hunterchev/baffle-muffler/out/handoff/MUF-000_assembly.dxf

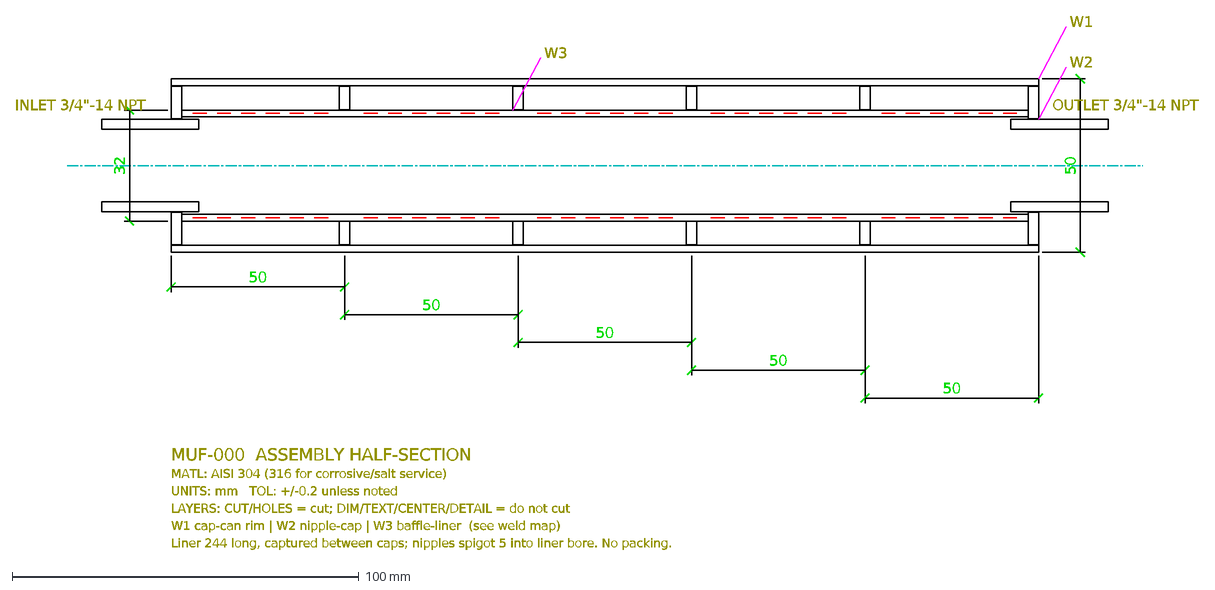
[picture p1: CAD file, 2026-10-25]
out/handoff/MUF-000_assembly.dxf
50
32
W1
W2
W3
INLET 3/4"-14 NPT
OUTLET 3/4"-14 NPT
MUF-000 ASSEMBLY HALF-SECTION
MATL: AISI 304 (316 for corrosive/salt service)
UNITS: mm TOL: +/-0.2 unless noted
LAYERS: CUT/HOLES = cut; DIM/TEXT/CENTER/DETAIL = do not cut
W1 cap-can rim | W2 nipple-cap | W3 baffle-liner (see weld map)
Liner 244 long, captured between caps; nipples spigot 5 into liner bore. No packing.
