hunterchev/baffle-muffler/out/handoff/MUF-001_outer_can.dxf

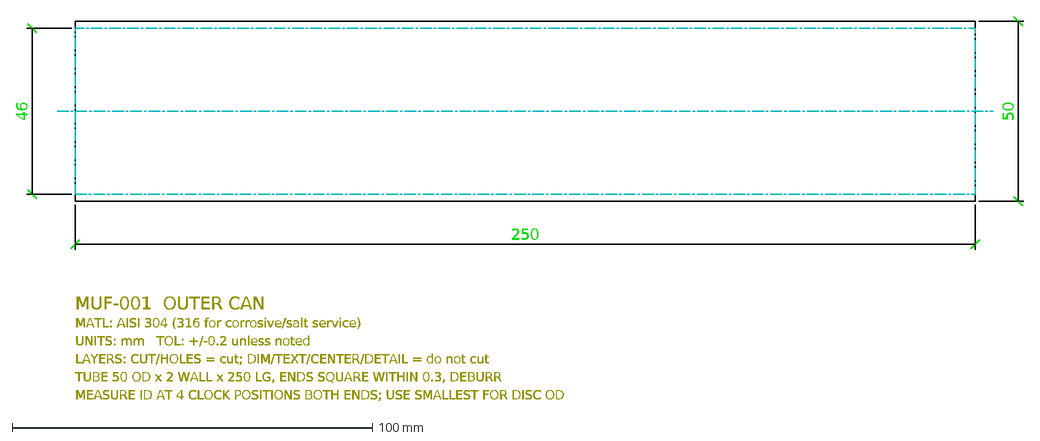
[picture p2: CAD file, 2026-10-25]
out/handoff/MUF-001_outer_can.dxf
250
50
46
MUF-001 OUTER CAN
MATL: AISI 304 (316 for corrosive/salt service)
UNITS: mm TOL: +/-0.2 unless noted
LAYERS: CUT/HOLES = cut; DIM/TEXT/CENTER/DETAIL = do not cut
TUBE 50 OD x 2 WALL x 250 LG, ENDS SQUARE WITHIN 0.3, DEBURR
MEASURE ID AT 4 CLOCK POSITIONS BOTH ENDS; USE SMALLEST FOR DISC OD
