hunterchev/baffle-muffler/out/handoff/drill_jig.dxf

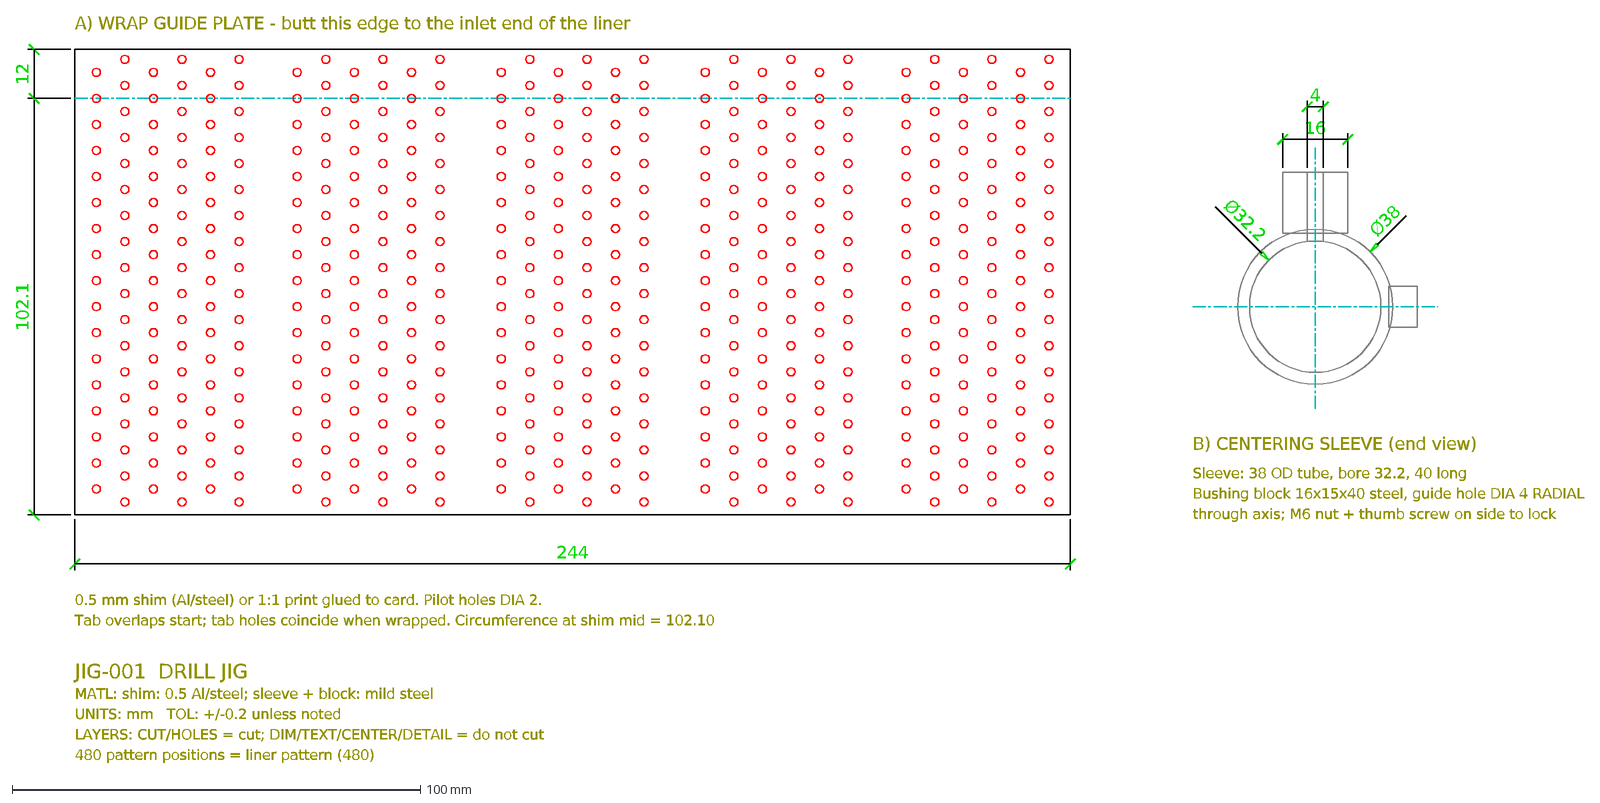
[picture p3: CAD file, 2026-10-25]
out/handoff/drill_jig.dxf
244
102.1
12
A) WRAP GUIDE PLATE - butt this edge to the inlet end of the liner
0.5 mm shim (Al/steel) or 1:1 print glued to card. Pilot holes DIA 2.
Tab overlaps start; tab holes coincide when wrapped. Circumference at shim mid = 102.10
Ø38
Ø32.2
16
4
B) CENTERING SLEEVE (end view)
Sleeve: 38 OD tube, bore 32.2, 40 long
Bushing block 16x15x40 steel, guide hole DIA 4 RADIAL
through axis; M6 nut + thumb screw on side to lock
JIG-001 DRILL JIG
MATL: shim: 0.5 Al/steel; sleeve + block: mild steel
UNITS: mm TOL: +/-0.2 unless noted
LAYERS: CUT/HOLES = cut; DIM/TEXT/CENTER/DETAIL = do not cut
480 pattern positions = liner pattern (480)
