hunterchev/baffle-muffler/out/handoff/MUF-004_baffle.dxf

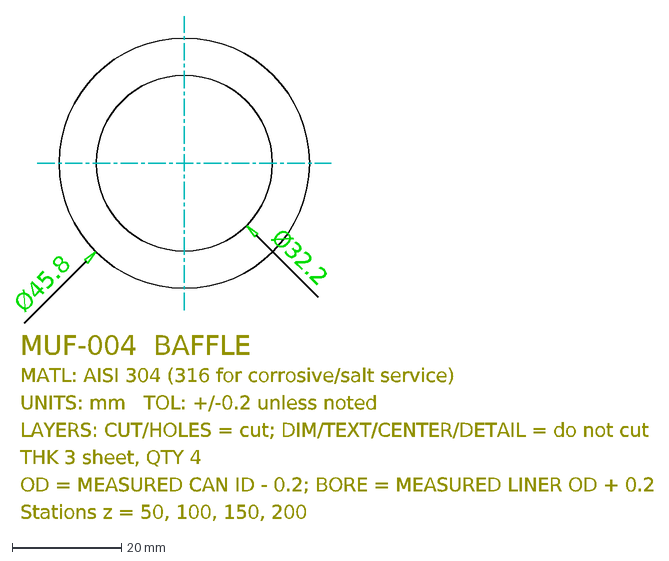
[picture p4: CAD file, 2026-10-25]
out/handoff/MUF-004_baffle.dxf
Ø45.8
Ø32.2
MUF-004 BAFFLE
MATL: AISI 304 (316 for corrosive/salt service)
UNITS: mm TOL: +/-0.2 unless noted
LAYERS: CUT/HOLES = cut; DIM/TEXT/CENTER/DETAIL = do not cut
THK 3 sheet, QTY 4
OD = MEASURED CAN ID - 0.2; BORE = MEASURED LINER OD + 0.2
Stations z = 50, 100, 150, 200
