hunterchev/baffle-muffler/out/handoff/MUF-003_end_cap.dxf

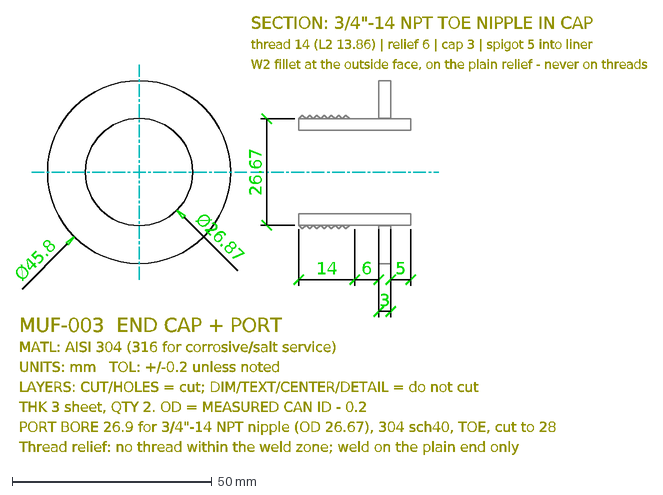
[picture p5: CAD file, 2026-10-25]
out/handoff/MUF-003_end_cap.dxf
Ø45.8
Ø26.87
14
6
3
5
26.67
SECTION: 3/4"-14 NPT TOE NIPPLE IN CAP
thread 14 (L2 13.86) | relief 6 | cap 3 | spigot 5 into liner
W2 fillet at the outside face, on the plain relief - never on threads
MUF-003 END CAP + PORT
MATL: AISI 304 (316 for corrosive/salt service)
UNITS: mm TOL: +/-0.2 unless noted
LAYERS: CUT/HOLES = cut; DIM/TEXT/CENTER/DETAIL = do not cut
THK 3 sheet, QTY 2. OD = MEASURED CAN ID - 0.2
PORT BORE 26.9 for 3/4"-14 NPT nipple (OD 26.67), 304 sch40, TOE, cut to 28
Thread relief: no thread within the weld zone; weld on the plain end only
