hunterchev/baffle-muffler/out/handoff/MUF-002_liner_wrap_layout.dxf

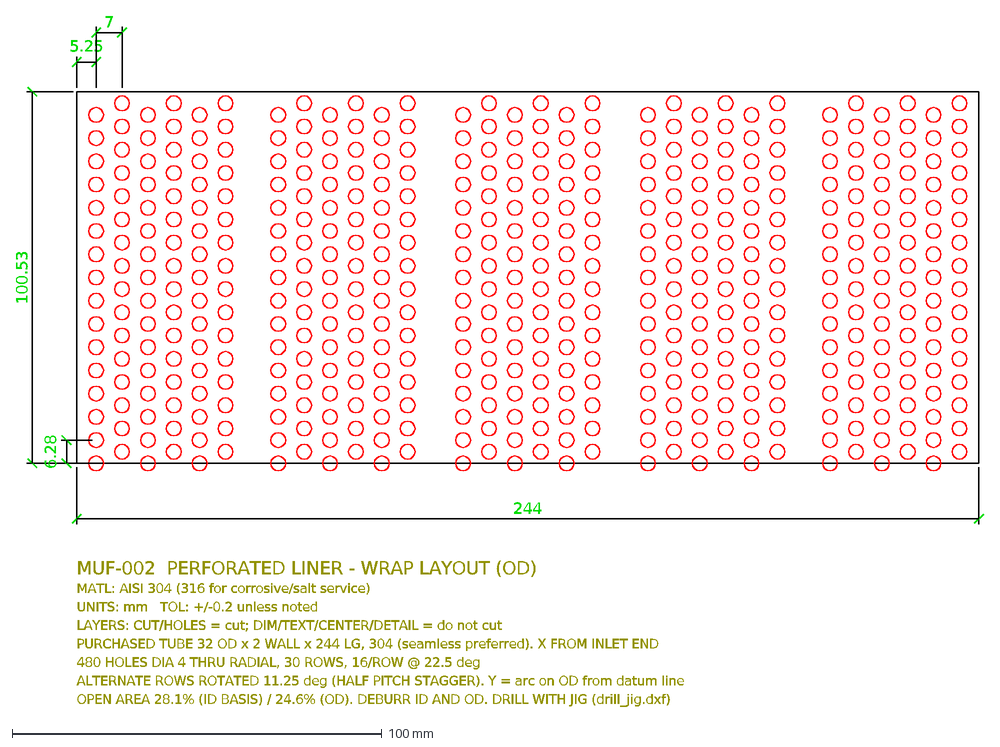
[picture p6: CAD file, 2026-10-25]
out/handoff/MUF-002_liner_wrap_layout.dxf
244
100.53
5.25
7
6.28
MUF-002 PERFORATED LINER - WRAP LAYOUT (OD)
MATL: AISI 304 (316 for corrosive/salt service)
UNITS: mm TOL: +/-0.2 unless noted
LAYERS: CUT/HOLES = cut; DIM/TEXT/CENTER/DETAIL = do not cut
PURCHASED TUBE 32 OD x 2 WALL x 244 LG, 304 (seamless preferred). X FROM INLET END
480 HOLES DIA 4 THRU RADIAL, 30 ROWS, 16/ROW @ 22.5 deg
ALTERNATE ROWS ROTATED 11.25 deg (HALF PITCH STAGGER). Y = arc on OD from datum line
OPEN AREA 28.1% (ID BASIS) / 24.6% (OD). DEBURR ID AND OD. DRILL WITH JIG (drill_jig.dxf)
