hunterchev/baffle-muffler/out/handoff/build_book.md

# Build Book - 50 x 250 Baffle Muffler (TIG)

Everything here is generated by `muffler.py`; re-run it after measuring stock (step 1).
Drawings: `MUF-000..004*.dxf`, `drill_jig.dxf` (PNG previews in `png/`). Build order: `sequence.mmd`.

## 1. Materials

| Part | Item | Material / size | Qty | Notes | Source |
|---|---|---|---|---|---|
| MUF-000 | Muffler assembly | - | 1 | Weldment; MUF-000 DXF, weld map, build book | - |
| MUF-001 | Outer can | 304 tube 50 OD x 2 wall | 1 | Cut 250 +/-0.5, square ends, deburr. Measure ID x4. | Online Metals 50x2 304, 60 in length (MTR available) or Amazon 50x2x400 mm (cut to 250) |
| MUF-002 | Perforated liner | 304 tube 32 OD x 2 wall (seamless pref.) | 1 | Cut 244 +/-0.3; 480x DIA 4 radial per drilling spec, using JIG-001; deburr ID+OD | AliExpress 32x2 304 tube, 300 mm (cut to 250) or uxcell 32x2 on Amazon. Fallback rolled 2 mm sheet = 7 holes/row + W4 seam variant (not generated here) |
| MUF-003 | End cap | 304, 3 sheet | 2 | Laser: OD 45.8, port bore 26.9 for the nipple | 3 mm 304 plate; laser-cut service (SendCutSend, OSH Cut, local shop) from MUF-003/004 DXF |
| MUF-004 | Baffle | 304, 3 sheet | 4 | Laser: OD 45.8, bore 32.2 | 3 mm 304 plate; laser-cut service (SendCutSend, OSH Cut, local shop) from MUF-003/004 DXF |
| MUF-005 | Port nipple 3/4"-14 NPT | 304 sch40 pipe nipple, thread one end (TOE), 2 in long | 2 | Cut plain end to 28 overall (14 thread + 6 relief + 3 cap + 5 spigot); deburr | McMaster-Carr / plumbing or industrial supply (304 TOE nipple) |
| MUF-006 | TIG filler rod | ER308L 1/16 in (1.6 mm); ER316L if 316 | 1 | ~0.25 kg tube | Welding supply |
| JIG-001 | Drill jig | 0.5 mm shim + 38 OD tube + steel block + M6 nut | 1 | See jig_build.md | Shim stock + scrap |

**Sourcing:**
- **Liner** (32 x 2 304 tube): AliExpress 32x2 304 tube, 300 mm (cut to 250) or uxcell 32x2 on Amazon. Fallback rolled 2 mm sheet = 7 holes/row + W4 seam variant (not generated here).
  Marketplace tube is often off-size: measure OD and wall on arrival before drilling.
- **Can** (50 x 2 304 tube): Online Metals 50x2 304, 60 in length (MTR available) or Amazon 50x2x400 mm (cut to 250).
- **Discs** (caps + baffles): 3 mm 304 plate; laser-cut service (SendCutSend, OSH Cut, local shop) from MUF-003/004 DXF. Order **after** measuring the tube (step 1).
- US imperial near-equivalents if metric is short: 2 in x 0.083 in (can), 1-1/4 in x 0.083 in = 31.75 x 2.11 (liner);
  the measure-and-rerun step absorbs the size difference.
- 316/316L if the vehicle sees road salt or marine use; then use ER316L filler.
- Filler ER308L 1/16 in (ER316L for 316), 2% lanthanated tungsten, argon.

## 2. Tools

Bandsaw or abrasive cutoff, drill press with V-block, Ø4 mm cobalt (HSS-Co) jobber drills (buy 5+),
center punch, small round file / deburr tool, flap wheel, 3/4"-14 NPT thread ring gauge or a mating fitting,
calipers (ID jaws), TIG welder (shop machine: 220 V, 110 A max, DC/pulse), argon with flowmeter + purge line,
stainless-only wire brush, acetone, foil tape, soapy water, 3/4"-14 NPT pipe cap + plug with Schrader valve.

## 3. Build sequence

1. **Measure**
   - Can ID at 4 clock positions, both ends -> smallest value. Liner OD likewise -> largest.
   - Re-run `muffler.py --can-id <ID> --liner-od <OD>`; discs become OD = ID - 0.2, bore = OD + 0.2.
2. **Cut**
   - Can to 250 +/-0.5 and liner to 244 +/-0.3, ends square within 0.3 (check with a square). Deburr.
   - Cut the two 3/4"-14 NPT TOE nipples to 28 overall from the plain end. Deburr.
   - Order/cut discs: 2x MUF-003 caps (port bore 26.9), 4x MUF-004 baffles. Cut the JIG-001 guide plate.
3. **Jig** - build the centering sleeve per `jig_build.md`.
4. **Drill** (liner)
   - Wrap guide plate, edge flush with the inlet end, tape tight. Center punch all 480 pilot holes. Remove.
   - Sleeve on liner, Ø4 pin through guide bushing into each punch mark, lock thumb screw, drill Ø4
     straight through the guide. ~950 rpm for Ø4 in 304, cutting fluid, steady feed (304 work-hardens if the
     drill rubs); swap drills as soon as they squeal.
   - Deburr OD (file/flap wheel) and ID (round file, brush). Blow out chips.
5. **Clean** - acetone on all parts; stainless-only brushes; no grinding discs used on carbon steel.
6. **Fit**
   - Slide baffles onto liner at z = 50, 100, 150, 200 (centres) using spacer blocks
     (45.5 mm from the liner's inlet end, 47 mm between baffles).
     Baffles sit on undrilled bands.
   - Dry-fit liner + baffles into can, caps + nipples in both ends: caps flush, spigots enter the liner bore,
     liner captured with no end play.
7. **Weld W3** (baffles to liner)
   - Foil-tape both liner ends, argon purge the bore 4-6 L/min.
   - Check square, 4 tacks per baffle @ 90 deg, re-check square, continuous fillet on the upstream face.
8. **Weld W2** (nipples to caps, on the bench)
   - Nipple through the cap bore: spigot 5 mm proud of the inner face, 6 mm plain relief outside.
   - Thread a 3/4"-14 NPT pipe cap on to protect the threads; purge through the nipple.
   - 4 tacks, check square, continuous fillet on the outside face, on the plain section only.
9. **Fit can** - slide the liner/baffle core into the can. No packing: absorption is by the baffles only.
10. **Cap**
    - Press caps in flush both ends; spigots enter the liner bore. Purge through a nipple (the perforations
      carry argon into the chambers).
    - 4 tacks each, then W1 (cap to can rim), alternating ends to limit distortion.
11. **Finish** - pickle/passivate welds; chase threads with a mating fitting; run `verification_checklist.md`.

## 4. TIG parameters

| ID | Joint | DC (DCEN) | Pulse (recommended) | Argon | Back-purge | Filler |
|---|---|---|---|---|---|---|
| W1 | End cap OD to can rim | 65-85 A | base 40-60 A, peak 100 A, 30-50 Hz | 8-10 L/min (gas lens 10-12) | 4-6 L/min | ER308L 1/16 in |
| W2 | Port nipple (3/4"-14 NPT) to end cap | 80-100 A | base 60-80 A, peak 100 A, 30-50 Hz | 8-10 L/min (gas lens 10-12) | 4-6 L/min | ER308L 1/16 in |
| W3 | Baffle ID to liner OD | 80-100 A | base 60-80 A, peak 100 A, 30-50 Hz | 8-10 L/min (gas lens 10-12) | 4-6 L/min | ER308L 1/16 in |

Shop machine: 220 V input, 110 A max, AC/DC/pulse, back-purge available.

- **DCEN for all joints.** AC is for aluminium; don't use it on stainless.
- **Pulse is recommended** on 2 mm 304: lower heat input means less burn-through at hole webs and less sugaring.
  Use 30-50 Hz with about 40% peak time.
- W2 (2.9 mm nipple wall to 3 mm cap) and W3 (2 mm liner to 3 mm baffle) are both tube-to-disc fillets, so they
  share settings. W1 is an edge/corner joint at the can rim with little mass, so it runs cooler.
- Peak current never exceeds 100 A, which leaves headroom on the 110 A machine.
- Gas: Ar 8-10 L/min (10-12 with a gas lens); postflow 8-10 s. 2% lanthanated 1/16 in tungsten, #7 cup.
- **Back-purge 4-6 L/min on every hollow joint** (W3 on the liner, W2 through the nipple, W1 through a nipple
  once capped). The perforations carry argon into the chambers. This stops internal oxidation.
- Tack first (4 per circular joint), then continuous. No preheat for TIG on 304. Interpass < 150 C.
- No W4: the liner is bought tube, so there is no shop seam. With welded tube the factory seam may be drilled through.

## 5. Troubleshooting

| Problem | Cause | Fix |
|---|---|---|
| Burn-through | Too hot for 2 mm; heat builds up near holes | Drop 10 A, add filler earlier, faster travel, copper heat sink, weld in quarters |
| Oval / wandering holes | Drill walks on the curved surface; dull drill or rubbing | Deep punch, drill through the sleeve guide, V-block, sharp cobalt, keep feeding |
| Broken Ø4 drill | Rubbing/work-hardening, chips packing | Peck, cutting fluid, fresh drill; don't drill out a broken bit, skip that position (1 hole = 0.06% open area) |
| Port thread leaks | No sealant, thread damaged by weld heat | Nickel anti-seize, not PTFE; keep W2 on the relief; chase thread with a fitting |
| Cap/baffle won't enter can | Tube ID undersize/out of round, burr, weld bead | Re-measure smallest ID, file disc edge, rerun with `--can-id`, deburr can ends |
| Cap loose (> 0.5 gap) | ID oversize | Remake discs from measured ID; don't bridge big gaps with filler |
| Sugaring (grey crust) on root | No back-purge | Purge liner bore; perforations carry argon into chambers |
| Filler choice | - | 304 -> ER308L; 316 -> ER316L; stainless to mild-steel flange -> ER309L; never ER70S on stainless |
