hunterchev/baffle-muffler/out/handoff/jig_build.md

# Drill Jig (JIG-001) - Build Steps

Two parts (`drill_jig.dxf`):
- **A. Wrap guide plate:** 0.5 mm shim, 244 x 114.1 mm, with all 480 pattern positions as
  Ø2 pilots. It carries the 16-hole rows (22.5 deg = 6.28 mm
  on OD), 7 mm row pitch and the 11.25 deg half-pitch stagger, so nothing is laid out by hand.
- **B. Centering sleeve:** keeps every hole radial (through the tube axis).

## A. Guide plate
1. Laser-cut the DXF layers `CUT` + `HOLES` in 0.5 mm aluminium or steel shim, **or** print the DXF 1:1
   (check the 244 mm dimension with calipers) and glue it to thin card.
2. Wrap on the liner, long edge flush with the inlet end, overlap tab on top; the tab holes must sit over the
   start holes. Tape tight; no gaps.

## B. Centering sleeve
1. Cut 40 mm of 38 mm OD tube; bore/hone so the liner slides with ~0.2 clearance
   (target 32.2). 1-1/2 in x 0.120 in tube (ID 32.0) fits a 1-1/4 in liner directly.
2. Weld a 16 x 15 x 40 steel block centred on top (bushing).
3. Put the sleeve in a V-block on the drill press, find the centre line by touching off both sides, and drill
   Ø4 through the block into the bore, **on the axis**. Ream if you have one.
4. Weld an M6 nut on the side, drill through, fit a thumb screw (brass tip or pad so it doesn't mark the liner).
5. Check: on scrap tube drill one hole, rotate 180 deg and drill again; the two holes must line up through the axis.

## Use
Punch through the guide plate, remove it. Slide the sleeve on, drop a Ø4 pin through the bushing into the
punch mark, lock it, drill Ø4 straight through the guide, move on. 480 holes: work row by row and
tick rows off on the checklist.
