hunterchev/baffle-muffler/(commit log)

2026-10-25 Baffle muffler: generator, TIG handoff package, build book PDF
    [MUF-000_assembly.dxf, MUF-001_outer_can.dxf, MUF-002_liner_wrap_layout.dxf, MUF-003_end_cap.dxf, MUF-004_baffle.dxf, bom.csv, drill_jig.dxf]
2026-10-25 Compact baffle layout: 480 x Ø4 holes, 3/4"-14 NPT weld-in port nipples, no packing
    - 16 holes/row, 30 rows @ 7 mm (6 per chamber, clear of baffle/cap welds), 11.25° stagger
    - PORT_THREAD parameter; TOE nipple with 6 mm thread relief and spigot into liner; liner captured (244 mm)
    - Core fill removed; W2 is now nipple-to-cap on the bench
    - Reference-only geometry moved to a do-not-cut DETAIL layer in cap and jig DXFs
    - Build book PDF, jig, checklist, BOM and checks regenerated
    [MUF-000_assembly.dxf, MUF-001_outer_can.dxf, MUF-002_liner_wrap_layout.dxf, MUF-003_end_cap.dxf, MUF-004_baffle.dxf, bom.csv, drill_jig.dxf]
